GadgetReboot/OpAmp_Buffer/README.md

# OpAmp_Buffer
Op Amp Input and Output buffer with Phone jacks for guitar effects prototyping
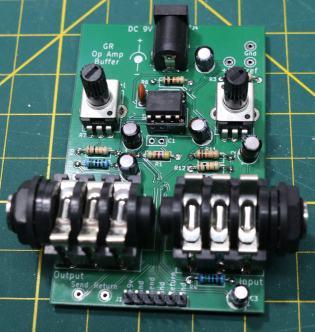
[picture p1: Assembled_PCB.JPG]
PCB
<br><br><BR><BR>
