GadgetReboot/OpAmp_Buffer/GR_OpAmp_Buffer_Sch.pdf

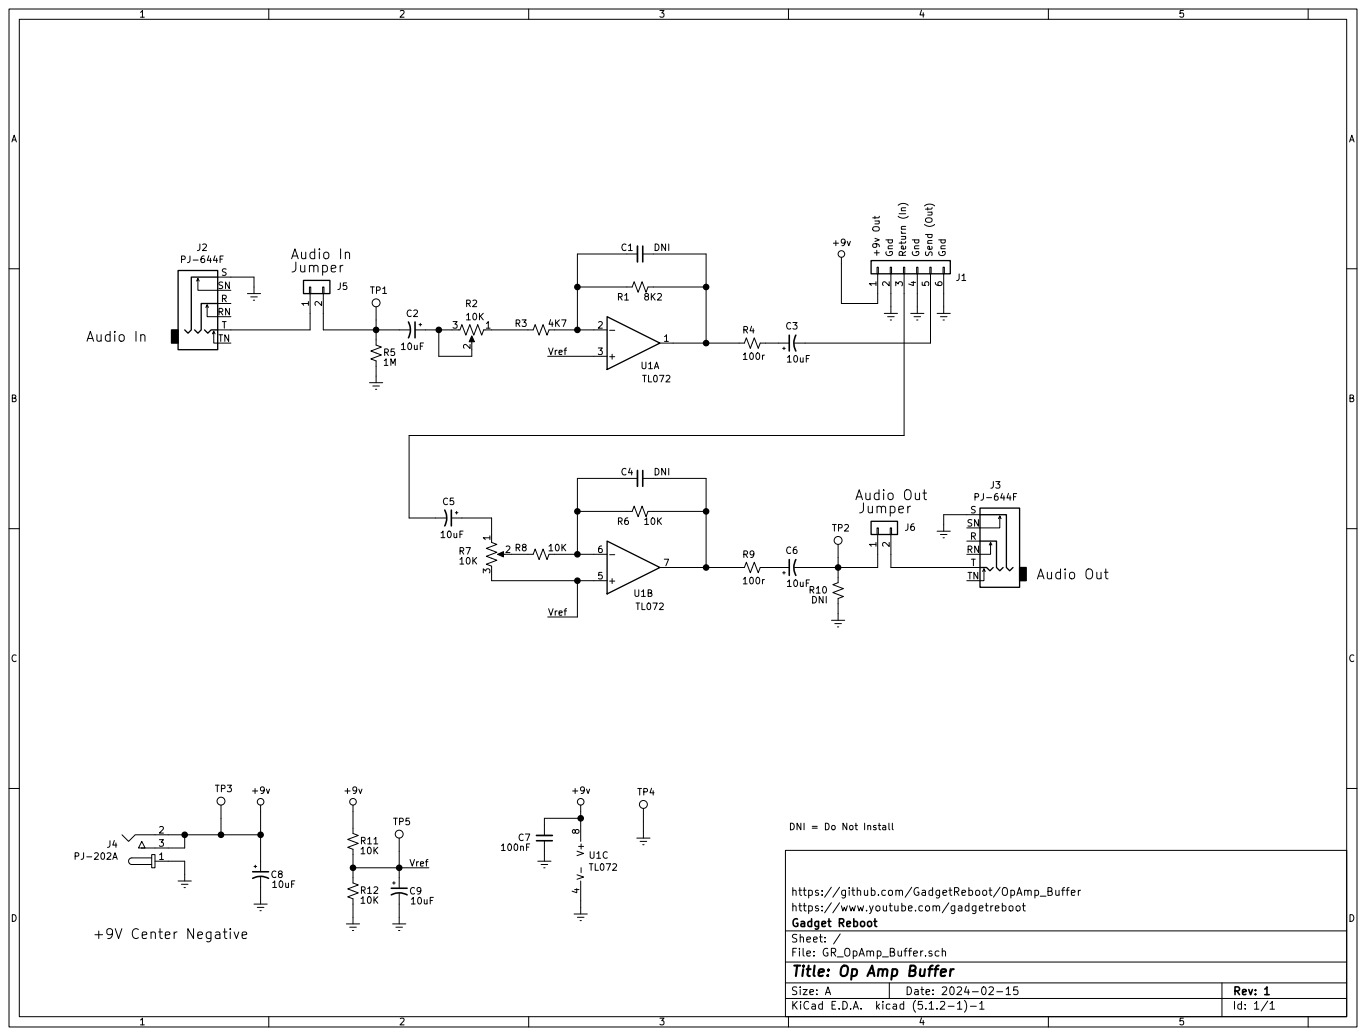
[picture p2: page 1]

https://github.com/GadgetReboot/OpAmp_Buffer +

https://www.youtube.com/gadgetreboot
File: GR_OpAmp_Buffer.sch Sheet: / Gadget Reboot

Id: 1/1 Title: Op Amp Buffer
