GadgetReboot/OpAmp_Buffer/KiCad/GR_OpAmp_Buffer.kicad_pcb

## KiCad design KiCad/GR_OpAmp_Buffer.kicad_pcb (2024-02-16)

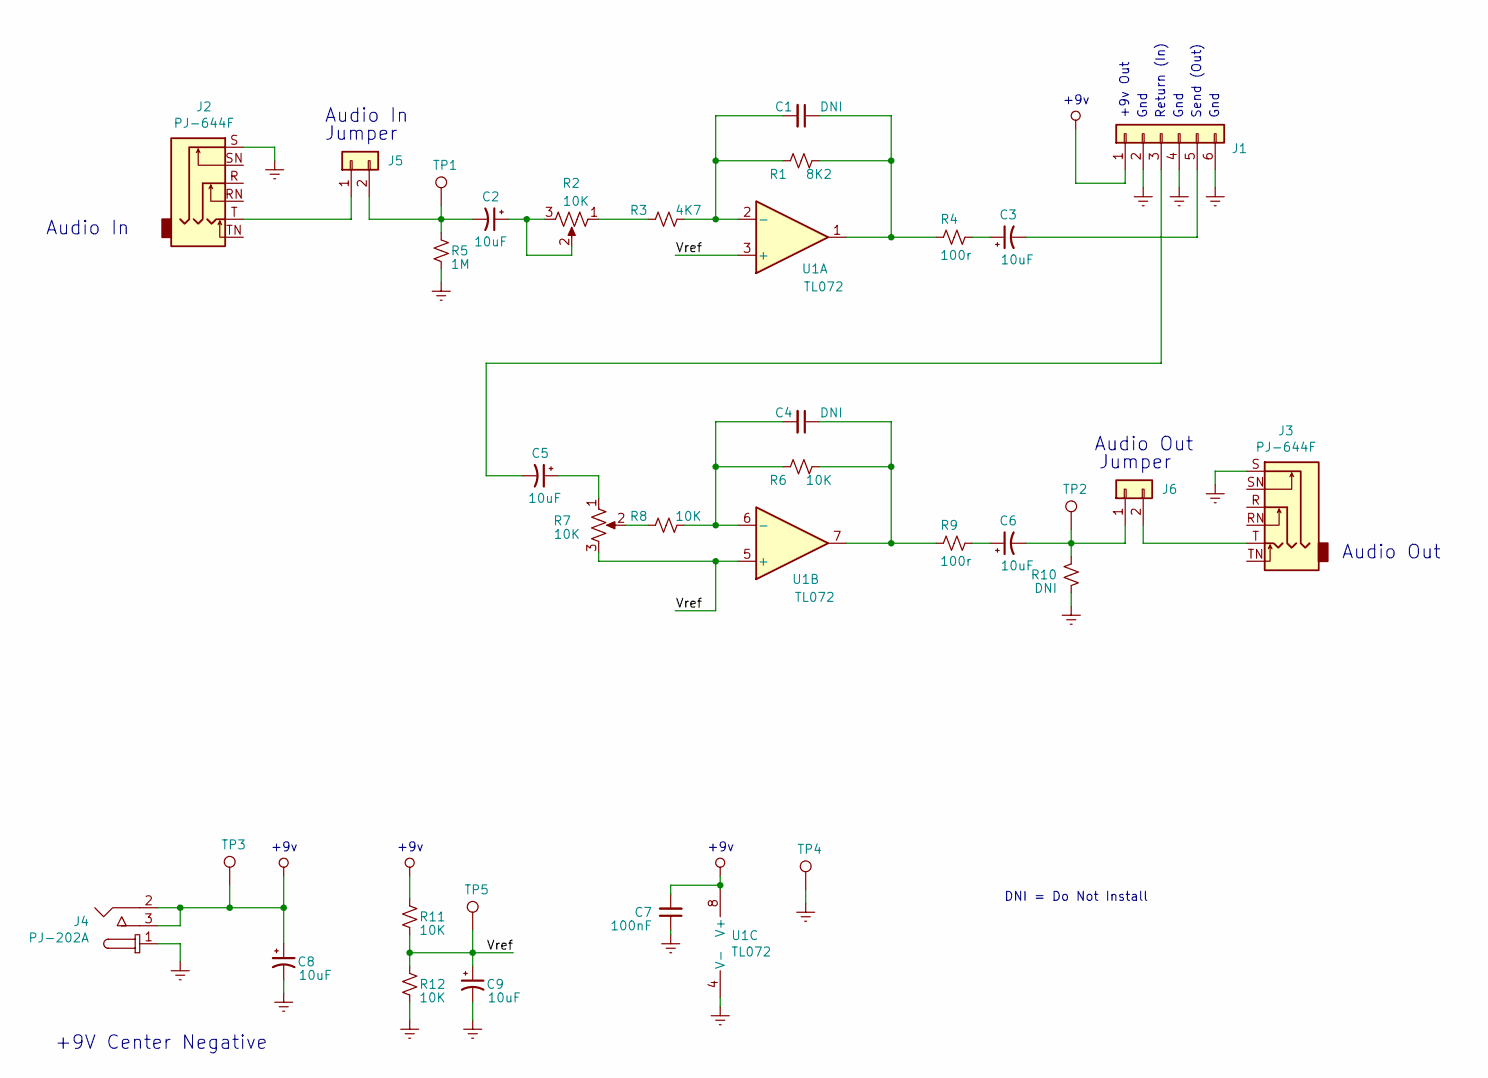
[picture p3: schematic GR_OpAmp_Buffer.sch, Op Amp Buffer]

Parts:
C1, C4: DNI; C_Disc_D5.0mm_W2.5mm_P2.50mm
C2, C3, C5, C6, C8, C9: 10uF; CP_Radial_D5.0mm_P2.50mm
C7: 100nF; C_Disc_D5.0mm_W2.5mm_P2.50mm
J1: Conn_01x06; PinHeader_1x06_P2.54mm_Vertical
J2, J3: PJ-644F; Jack_6.35mm_Neutrik_NMJ6HFD2_Horizontal
J4: PJ-202A; Barrel_Jack_5.5mmODx2.1mmID_PJ-202A; MPN PJ-202A; Digi-Key_PN CP-202A-ND
J5, J6: Conn_01x02; PinHeader_1x02_P2.54mm_Vertical
R1: 8K2; R_Axial_DIN0207_L6.3mm_D2.5mm_P10.16mm_Horizontal
R2, R7: 10K; Potentiometer_Bourns_PTV09A-1
R3: 4K7; R_Axial_DIN0207_L6.3mm_D2.5mm_P10.16mm_Horizontal
R4, R9: 100r; R_Axial_DIN0207_L6.3mm_D2.5mm_P10.16mm_Horizontal
R5: 1M; R_Axial_DIN0207_L6.3mm_D2.5mm_P10.16mm_Horizontal
R6, R8, R11, R12: 10K; R_Axial_DIN0207_L6.3mm_D2.5mm_P10.16mm_Horizontal
R10: DNI; R_Axial_DIN0207_L6.3mm_D2.5mm_P10.16mm_Horizontal
TP1, TP2, TP3, TP4, TP5: TestPoint; TestPoint_Loop_D1.80mm_Drill1.0mm_Beaded
U1: TL072; DIP-8_W7.62mm

Connections:
/Vref: C9.1, R7.3, R11.1, R12.2, TP5.1, U1.3 (+), U1.5 (+)
GNDREF: C7.1, C8.2, C9.2, J1.2, J1.4, J1.6, J2.S, J3.S, J4.1, R5.1, R10.1, R12.1, TP4.1, U1.4 (V-)
unnamed: C1.1, R1.1, R4.2, U1.1
unnamed: C1.2, R1.2, R3.1, U1.2 (-)
unnamed: C2.1, R2.2, R2.3
unnamed: C2.2, J5.2, R5.2, TP1.1
unnamed: C3.1, R4.1
unnamed: C3.2, J1.5
unnamed: C4.1, R6.1, R9.2, U1.7
unnamed: C4.2, R6.2, R8.1, U1.6 (-)
unnamed: C5.1, R7.1
unnamed: C5.2, J1.3
unnamed: C6.1, R9.1
unnamed: C6.2, J6.1, R10.2, TP2.1
unnamed: J2.T, J5.1
unnamed: J3.T, J6.2
unnamed: R2.1, R3.2
unnamed: R7.2, R8.2
VCC: C7.2, C8.1, J1.1, J4.2, J4.3, R11.2, TP3.1, U1.8 (V+)

Notes on the sheet:
DNI = Do Not Install
+9v
Gnd
+9v Out
Send (Out)
Return (In)
Audio In
Audio Out
+9V Center Negative
Jumper

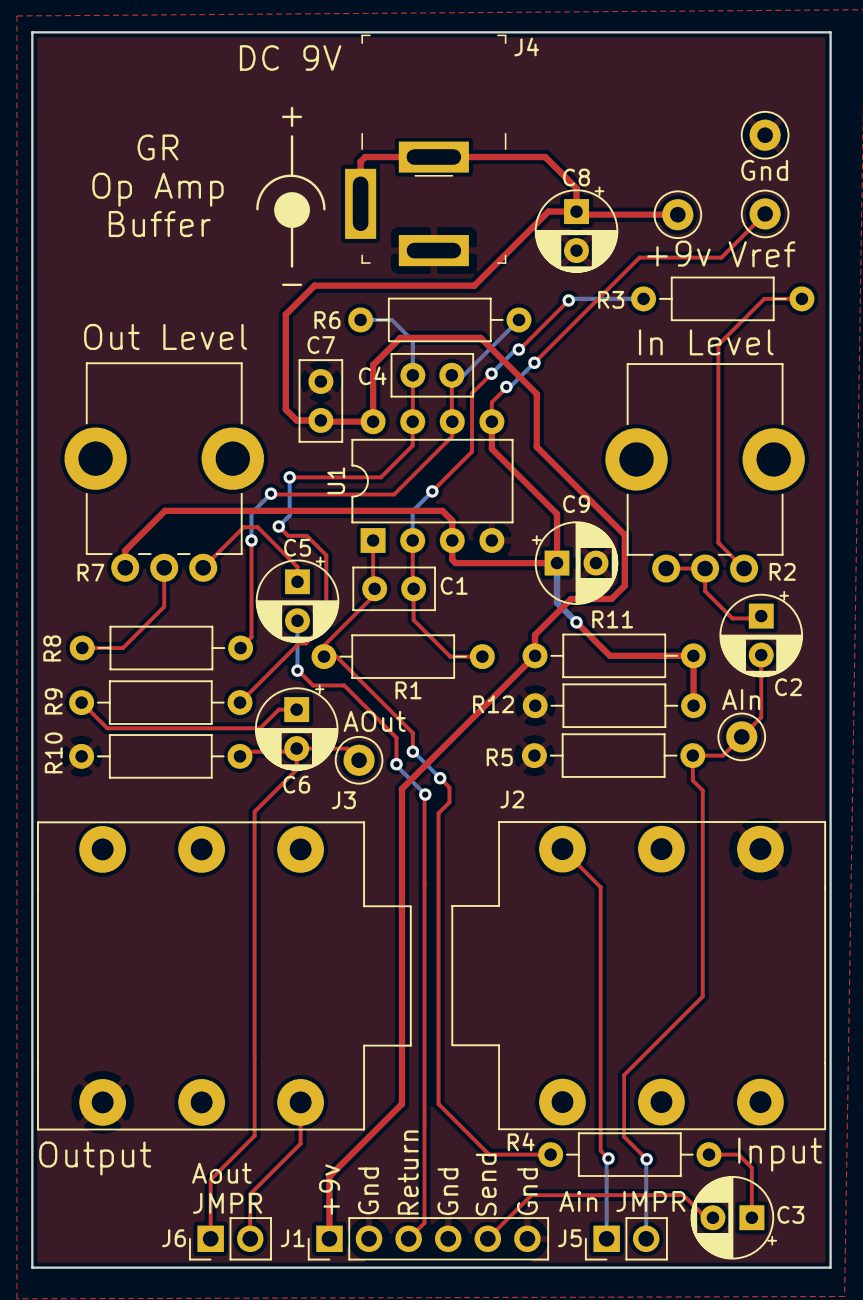
[picture p4: board GR_OpAmp_Buffer.kicad_pcb from above]

Board: 2 copper layers, 51.2 x 79.2 mm, 33 parts (0 on the bottom side), 19 nets.
